nwestern93/Rover_Project/Motor_control/main.c

#include <stdio.h>
#include <stdlib.h>
#include "stm32f0xx.h"
#include "motor.h"

/* -------------------------------------------------------------------------------------------------------------
 *  Global Variable Declarations
 *  -------------------------------------------------------------------------------------------------------------
 */
volatile uint32_t debouncer;

/* -------------------------------------------------------------------------------------------------------------
 *  Miscellaneous Core Functions
 *  -------------------------------------------------------------------------------------------------------------
 */

void LED_init(void) {
    // Initialize PC8 and PC9 for LED's
    RCC->AHBENR |= RCC_AHBENR_GPIOCEN;                                          // Enable peripheral clock to GPIOC
    GPIOC->MODER |= GPIO_MODER_MODER8_0 | GPIO_MODER_MODER9_0;                  // Set PC8 & PC9 to outputs
    GPIOC->OTYPER &= ~(GPIO_OTYPER_OT_8 | GPIO_OTYPER_OT_9);                    // Set to push-pull output type
    GPIOC->OSPEEDR &= ~((GPIO_OSPEEDR_OSPEEDR8_0 | GPIO_OSPEEDR_OSPEEDR8_1) |
                        (GPIO_OSPEEDR_OSPEEDR9_0 | GPIO_OSPEEDR_OSPEEDR9_1));   // Set to low speed
    GPIOC->PUPDR &= ~((GPIO_PUPDR_PUPDR8_0 | GPIO_PUPDR_PUPDR8_1) |
                      (GPIO_PUPDR_PUPDR9_0 | GPIO_PUPDR_PUPDR9_1));             // Set to no pull-up/down
    GPIOC->ODR &= ~(GPIO_ODR_8 | GPIO_ODR_9);                                   // Shut off LED's
}

void  button_init(void) {
    // Initialize PA0 for button input
    RCC->AHBENR |= RCC_AHBENR_GPIOAEN;                                          // Enable peripheral clock to GPIOA
    //GPIOA->MODER &= ~(GPIO_MODER_MODER0_0 | GPIO_MODER_MODER0_1);               // Set PA0 to input
    //GPIOC->OSPEEDR &= ~(GPIO_OSPEEDR_OSPEEDR0_0 | GPIO_OSPEEDR_OSPEEDR0_1);     // Set to low speed
    //GPIOC->PUPDR |= GPIO_PUPDR_PUPDR0_1;                                        // Set to pull-down
}


//commented out 03/30/23
/* Called by SysTick Interrupt
 * Performs button debouncing, changes wave type on button rising edge
 * Updates frequency output from ADC value
 */
//void HAL_SYSTICK_Callback(void) {
    // Remember that this function is called by the SysTick interrupt
    // You can't call any functions in here that use delay

    //debouncer = (debouncer << 1);
    //if(GPIOA->IDR & (1 << 0)) {
    //    debouncer |= 0x1;
    //}

    //if(debouncer == 0x7FFFFFFF) {
    //switch(target_rpm) {
    //    case 80:
    //        target_rpm = 50;
    //        break;
    //    case 50:
    //        target_rpm = 81;
    //        break;
    //    case 0:
    //        target_rpm = 80;
    //        break;
    //    default:
    //        target_rpm = 0;
    //        break;
    //    }
    //}
//}

/* -------------------------------------------------------------------------------------------------------------
 * Main Program Code
 *
 * Starts initialization of peripherals
 * Blinks green LED (PC9) in loop as heartbeat
 * -------------------------------------------------------------------------------------------------------------
 */
volatile uint32_t right_encoder_count = 0;
volatile uint32_t left_encoder_count = 0;
int i = 0;
int main(int argc, char* argv[]) {

    debouncer = 0;                          // Initialize global variables
		HAL_Init();															// Initialize HAL
    LED_init();                             // Initialize LED's
    button_init();                          // Initialize button
		
    right_motor_init();                           // Initialize motor code
		left_motor_init();
    
		while (1) {
        GPIOC->ODR ^= GPIO_ODR_8;           // Toggle green LED (heartbeat)
        right_encoder_count = TIM2->CNT;
				left_encoder_count = TIM3->CNT;
				if(i ==0) {
					turn_left();
					i =1;
				}
				else if(i == 1) {
					turn_left();
					i = 2;
				}
				HAL_Delay(1280);                      // Delay 1/8 second
			
    }
}

// ----------------------------------------------------------------------------
