nwestern93/Rover_Project/(commit log)

2023-04-12 adding current motor control files
2023-04-14 front distance sensor code
2023-04-18 added ability to use variety pins for front sensor
2023-04-19 finding backup pins and enabled push button
2023-04-19 prepping for additional motor
2023-04-21 finalizing motor control for two motors simultaneously
2023-04-22 Motor.h added to inc folder in rover_obstacle
2023-04-23 adding in motor turning capabilities to test
2023-04-24 Add files via upload
    Alternate Ultrasonic Sensor using TIM1 if needed
2023-04-25 sensors test framework, working except for the IR is not updating or taking a second analog input
2023-04-25 Update i3g IR ADC Sensor Thresholds - main.c
2023-04-25 Rename i3g IR ADC Sensor Thresholds - main.c to GP2Y0A21YK IR ADC Sensor Thresholds - main.c
2023-04-25 Update GP2Y0A21YK IR ADC Sensor Thresholds - main.c
2023-04-25 updated code to allow both motors to spin togehter
2023-04-26 adding motor control
2023-04-26 added motor control to src
2023-04-26 Update and rename i3g_IR.c to GP2_IR.c
    The model of the IR Sensor(s) is actually GP2
2023-04-29 adc code
2023-04-29 Added commented out code for color sensor
2023-04-29 Enabled LED
2023-05-01 Update GP2_IR.c
    updated the ADC to pull
2023-05-02 added code for the mode selector, added code for auto driving and added code for backup plan if Ir sensors fail"
    [GP2_IR.c, backup.c, backup.h, main.c]
2023-05-02 cleaning up code and removing US and motor bugs
    [distance_front.c, motor.c]
2023-05-02 Extra color sensor .c file removed and comments added to sensor file to main within src
2023-05-03 working IR right sensor and manual drive mode is available
